BogeysParadise/SofleKeyboard/Sofle_RGB/Build_guide/perkey lighting.png

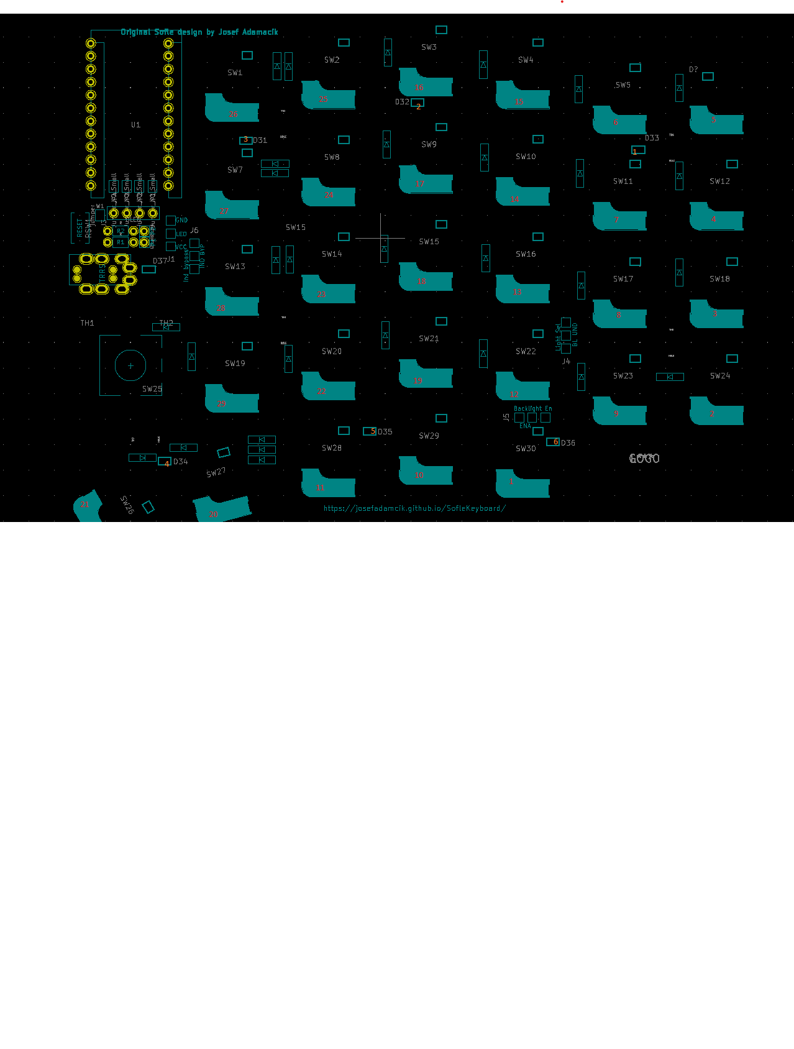
Sofle_RGB/Build_guide/perkey lighting.png
