BogeysParadise/SofleKeyboard/(commit log)

2020-09-26 footprints fixed, onto layout
    [SofleKeyboard.kicad_pcb, SofleKeyboard.sch]
2020-10-01 layout done. need schematic, footprint and pcb review
    [SofleKeyboard.kicad_pcb]
2020-10-08 going to move to a more so fle 2 layout
    [SofleKeyboard-B_Cu.gbl, SofleKeyboard-B_Mask.gbs, SofleKeyboard-B_SilkS.gbo, SofleKeyboard-Edge_Cuts.gm1, SofleKeyboard-F_Cu.gtl, SofleKeyboard-F_Mask.gts, SofleKeyboard-F_SilkS.gto, SofleKeyboard-NPTH.drl]
2020-10-08 added placement changes from r2, routed need to make any other changes, do pcb plates, and fix up the folders for mergeing
    [SofleKeyboard.kicad_pcb]
2020-10-09 release version of the sofle rgb, routing done, case made, there are some slight oddities in the spacing of some keys, but they are very small
    [SofleKeyboard-B_Cu.gbl, SofleKeyboard-B_Mask.gbs, SofleKeyboard-B_SilkS.gbo, SofleKeyboard-Edge_Cuts.gm1, SofleKeyboard-F_Cu.gtl, SofleKeyboard-F_Mask.gts, SofleKeyboard-F_SilkS.gto, SofleKeyboard-NPTH.drl]
2020-10-09 restructure for linux
    [SofleKeyboard.kicad_pcb, SofleKeyboard.sch]
2020-10-09 added gerbers
    [SofleKeyboard.kicad_pcb]
2020-10-15 updated gerbers, reviewed and happy for release
    [SofleKeyboard.kicad_pcb]
2020-10-15 updated release gerbers and added some DRC suppression so it passes without error
    [SofleKeyboard.sch]
2020-11-29 unknown changes
    [SofleKeyboard.kicad_pcb, SofleKeyboard.sch]
2020-12-17 fixed top and bottom plate hole sizes
    [SofleKeyboardBottomPlate.kicad_pcb, SofleKeyboardTopPlate.kicad_pcb]
2020-12-17 updated pcb - flip key that was on bottom, fix led fix diode orientation fix some diode placement
    [SofleKeyboard.kicad_pcb]
2020-12-19 updated pcbs, starting documentation
    [SofleKeyboard.kicad_pcb]
2020-12-24 updated gerbers
    [SofleKeyboard.kicad_pcb]
